B-Pence/Phob-Pro/PCB/KiCAD/TriggerBoard/TriggerBoard.kicad_pcb

## KiCad design PCB/KiCAD/TriggerBoard/TriggerBoard.kicad_pcb (2024-05-08)



Board: 2 copper layers, 41.7 x 9.7 mm, 5 parts (2 on the bottom side), 4 nets.

Parts:
H2: MouseBiteRA; breakaway-mousebites-double
J1: L; Pin_Header_Straight_1x02_Pitch2.54mm
J2: R; Pin_Header_Straight_1x02_Pitch2.54mm
SW1: L; Trigger_Contact_Big
SW2: R; Trigger_Contact_Big

Connections:
unnamed: J1.1, SW1.1
unnamed: J1.2, SW1.2
unnamed: J2.1, SW2.1
unnamed: J2.2, SW2.2
