B-Pence/Phob-Pro/(notices)

Notices in the files:
PCB/KiCAD/PhobGCC_2_0_0_proto_1.kicad_pcb:
CERN-OHL-S v2
Licensed under
